Luidooo/luidlab/rack/desenhos/02-estrutura.tex

% ============================================================
%  MR2020-02  Frame assembly
%  A4 portrait, scale 1:5, first angle projection
% ============================================================
%  Included by mr2020.tex; does not compile on its own.

% ---------- scale and view origins (sheet coordinates, mm) ----------
\def\Esc{0.2}                  % 1:5
\def\FX{58}  \def\FY{162.2}    % front view, lower left corner
\def\LX{120} \def\LY{162.2}    % left side view
\def\TX{58}  \def\TY{66}       % top view

% rectangle in real coordinates inside a view: \ret[style]{ox}{oy}{x1}{y1}{x2}{y2}
\newcommand{\ret}[7][linhaA]{%
  \draw[#1] ({#2+(#4)*\Esc},{#3+(#5)*\Esc}) rectangle ({#2+(#6)*\Esc},{#3+(#7)*\Esc});}
% top view: front at the bottom (first angle), p measured from back to front
% L bracket seen square-on, right angle at (a,z), legs da and dz: \cant{ox}{oy}{a}{z}{da}{dz}
\newcommand{\cant}[6]{%
  \filldraw[linhaA, fill=cantoneira] ({#1+(#3)*\Esc},{#2+(#4)*\Esc}) -- ({#1+(#3+(#5))*\Esc},{#2+(#4)*\Esc})
    -- ({#1+(#3)*\Esc},{#2+(#4+(#6))*\Esc}) -- cycle;}
\newcommand{\retT}[4]{%
  \draw[linhaA] ({\TX+(#1)*\Esc},{\TY+(350-(#2))*\Esc}) rectangle ({\TX+(#3)*\Esc},{\TY+(350-(#4))*\Esc});}
% flat L bracket in the top view, right angle at (x,p), legs dx and dp: \cantT{x}{p}{dx}{dp}
\newcommand{\cantT}[4]{%
  \filldraw[linhaA, fill=cantoneira] ({\TX+(#1)*\Esc},{\TY+(350-(#2))*\Esc})
    -- ({\TX+(#1+(#3))*\Esc},{\TY+(350-(#2))*\Esc}) -- ({\TX+(#1)*\Esc},{\TY+(350-(#2+(#4)))*\Esc}) -- cycle;}

\begin{folha}

% ============================================================
%  FRONT VIEW
% ============================================================
% uprights cut to 579 (3.5..582.5), corner connectors adding 3.5 at the bottom and at the top
\ret{\FX}{\FY}{0}{3.5}{20}{582.5}
\ret{\FX}{\FY}{186}{3.5}{206}{582.5}
\ret{\FX}{\FY}{0}{0}{20}{3.5}
\ret{\FX}{\FY}{186}{0}{206}{3.5}
\ret{\FX}{\FY}{0}{582.5}{20}{586}
\ret{\FX}{\FY}{186}{582.5}{206}{586}
% front width rails, top and bottom
\ret{\FX}{\FY}{20}{566}{186}{586}
\ret{\FX}{\FY}{20}{0}{186}{20}
% back plane L brackets, seen through the frame; the front plane ones at the vertices fall on the same outline
\foreach \x/\d in {20/\CantL,186/-\CantL}{
  \cant{\FX}{\FY}{\x}{566}{\d}{-\CantL}
  \cant{\FX}{\FY}{\x}{20}{\d}{\CantL}}
% axis of symmetry
\draw[linhaG] ({\FX+103*\Esc},{\FY-2}) -- ({\FX+103*\Esc},{\FY+586*\Esc+2});

% dimensions
\cotaHor{\FX+10*\Esc}{\FX+196*\Esc}{156.5}{\FY}{\FY}{186}
\cotaHor{\FX}{\FX+206*\Esc}{151}{\FY}{\FY}{206}
\cotaVer{\FY}{\FY+586*\Esc}{46}{\FX}{\FX}{586}

% detail A callout at the top left vertex
\draw[linhaB] ({\FX+2},{\FY+586*\Esc-1}) circle (4.5mm);
\node[font=\fontsize{3mm}{3.4mm}\selectfont\bfseries] at ({\FX+8},{\FY+586*\Esc+3.6}) {A};

\balao{1}{104.5}{266}{\FX+196*\Esc}{230}
\balao{2}{70}{262}{70}{\FY+576*\Esc}

\node[txtvista] at ({\FX+103*\Esc},144.5) {FRONT VIEW};

% ============================================================
%  LEFT SIDE VIEW (first angle: right of the front view, front on the right)
% ============================================================
\ret{\LX}{\LY}{0}{3.5}{20}{582.5}
\ret{\LX}{\LY}{330}{3.5}{350}{582.5}
\ret{\LX}{\LY}{0}{0}{20}{3.5}
\ret{\LX}{\LY}{330}{0}{350}{3.5}
\ret{\LX}{\LY}{0}{582.5}{20}{586}
\ret{\LX}{\LY}{330}{582.5}{350}{586}
\ret{\LX}{\LY}{20}{566}{330}{586}
\ret{\LX}{\LY}{20}{0}{330}{20}
% side L brackets at the four vertices
\cant{\LX}{\LY}{20}{566}{\CantL}{-\CantL}
\cant{\LX}{\LY}{20}{20}{\CantL}{\CantL}
\cant{\LX}{\LY}{330}{566}{-\CantL}{-\CantL}
\cant{\LX}{\LY}{330}{20}{-\CantL}{\CantL}

% dimensions
\cotaHor{\LX}{\LX+350*\Esc}{156.5}{\LY}{\LY}{350}

\node[txtrot] at ({\LX+340*\Esc},282.6) {FRONT};
\balao{5}{108}{236}{\LX+25*\Esc}{\LY+560*\Esc}
\balao{3}{155}{230}{155}{\LY+574*\Esc}

\node[txtvista] at ({\LX+175*\Esc},144.5) {LEFT SIDE VIEW};

% ============================================================
%  TOP VIEW (first angle: below the front view, front at the bottom)
% ============================================================
\retT{0}{0}{20}{20}     \retT{186}{0}{206}{20}
\retT{0}{330}{20}{350}  \retT{186}{330}{206}{350}
\retT{20}{0}{186}{20}   \retT{20}{330}{186}{350}
\retT{0}{20}{20}{330}   \retT{186}{20}{206}{330}
% flat L brackets of the top frame (the base ones lie under them)
\cantT{20}{20}{\CantL}{\CantL}     \cantT{186}{20}{-\CantL}{\CantL}
\cantT{20}{330}{\CantL}{-\CantL}   \cantT{186}{330}{-\CantL}{-\CantL}
\draw[linhaG] ({\TX+103*\Esc},{\TY-1.5}) -- ({\TX+103*\Esc},{\TY+70+2});
\draw[linhaG] ({\TX-2},{\TY+35}) -- ({\TX+206*\Esc+2},{\TY+35});

\cotaVer{\TY}{\TY+350*\Esc}{106}{\TX+206*\Esc}{\TX+206*\Esc}{350}

\node[txtrot] at ({\TX+103*\Esc},62.3) {FRONT};
\node[txtvista] at ({\TX+103*\Esc},57) {TOP VIEW};

% ============================================================
%  DETAIL A, scale 2:1: top vertex with the corner connector
% ============================================================
% mapping: X = 132 + 2x ;  Y = 96 + 2(z - 566)
\draw[linhaA] (132,90) -- (132,129);          % outer face of the upright
\draw[linhaA] (172,90) -- (172,136);          % inner face / rail abutment
\draw[linhaA] (132,129) rectangle (172,136);  % connector over the upright end
\draw[linhaA] (172,136) -- (196,136);         % width rail, top face
\draw[linhaA] (172,96) -- (196,96);           % width rail, bottom face
\quebraH{132}{172}{90}
\quebraV{196}{96}{136}
\cotaVer{129}{136}{126.5}{132}{132}{3.5}
\balao{4}{188}{142}{160}{133}

\node[txtvista] at (164,84.5) {DETAIL A  (2:1)};
\node[txtnota] at (164,80.9) {3.5 mm connector at each upright end, bottom mirrored};

% ============================================================
%  ITEM LIST
% ============================================================
\begin{scope}[shift={(110,47)}]
  \draw[line width=0.35mm] (0,0) rectangle (88,32.4);
  \draw[linhaA] (0,28.8) -- (88,28.8);
  \foreach \y in {3.6,7.2,...,25.2}{\draw[linhaB] (0,\y) -- (88,\y);}
  \foreach \x in {10,55,65}{\draw[linhaB] (\x,0) -- (\x,32.4);}
  \def\cab{\fontsize{1.9mm}{2.2mm}\selectfont\bfseries}
  \def\cel{\fontsize{2.2mm}{2.6mm}\selectfont}
  \node[font=\cab] at (5,30.6) {ITEM};
  \node[font=\cab, anchor=west] at (11.2,30.6) {DESCRIPTION};
  \node[font=\cab] at (60,30.6) {QTY};
  \node[font=\cab, anchor=west] at (66.2,30.6) {NOTE};
  \def\lin#1#2#3#4#5{%
    \node[font=\cel] at (5,#1) {#2};
    \node[font=\cel, anchor=west] at (11.2,#1) {#3};
    \node[font=\cel] at (60,#1) {#4};
    \node[font=\cel, anchor=west] at (66.2,#1) {#5};}
  \lin{27}{1}{Upright}{4}{cut 579}
  \lin{23.4}{2}{Width rail}{4}{cut 166}
  \lin{19.8}{3}{Depth rail}{4}{cut 310}
  \lin{16.2}{4}{3-way corner connector}{8}{4 in stock}
  \lin{12.6}{5}{L corner bracket, 2 holes}{24}{16 in stock}
  \lin{9}{6}{M5 hammer nut, 20 series}{48}{8 in stock}
  \lin{5.4}{7}{M5 × 8 button head hex screw}{48}{purchased}
  \lin{1.8}{8}{M4 × 3 headless hex screw}{64}{32 in stock}
\end{scope}

% ============================================================
%  NOTES
% ============================================================
\node[anchor=north west, txtnota, text width=31mm, align=left, inner sep=0pt] at (22,136) {%
  \hyphenpenalty=10000\exhyphenpenalty=10000
  {\fontsize{2.6mm}{3mm}\selectfont\bfseries NOTES}\\[1.4mm]
  1. All dimensions are in mm; keep in mind that 1U~=~1.75~in~=~44.45~mm.\\[1mm]
  2. Heights measured from the frame base, at the bottom face of the lower connectors.\\[1mm]
  3. Each corner connector adds 3.5~mm, at the top and at the bottom vertices: uprights are
     cut to 579 and the frame totals 586. See detail~A.\\[1mm]
  4. First angle projection. The front is on the right in the side view and at the bottom in
     the top view.\\[1mm]
  5. Rails only at the base and top frames: no intermediate rails.\\[1mm]
  6. Cut lengths on sheet~03.\\[1mm]
  7. L brackets (5), three at each vertex: side plane, front or back plane, and flat in the
     base or top frame. Each takes two hammer nuts (6) and two screws (7).};

\legenda{FRAME ASSEMBLY}{20 × 20 extrusion, 8 in. × 12U format}{MR2020-02}{1:5}{2}{5}

\end{folha}
