Luidooo/luidlab/rack/desenhos/04-vertices.tex

% ============================================================
%  MR2020-04  Corner details
%  A4 portrait, isometric drawings at 1:1
%  Top back right vertex: A from inside the frame, B from outside the frame
%  Included by mr2020.tex; does not compile on its own.
% ============================================================

% ---------- 2020 profile section, local coordinates centred on the profile ----------
\def\perfil{(-10,-10) -- (-3,-10) -- (-3,-8) -- (-5,-8) -- (-5,-5.5) -- (5,-5.5) -- (5,-8)
  -- (3,-8) -- (3,-10) -- (10,-10) -- (10,-3) -- (8,-3) -- (8,-5) -- (5.5,-5) -- (5.5,5)
  -- (8,5) -- (8,3) -- (10,3) -- (10,10) -- (3,10) -- (3,8) -- (5,8) -- (5,5.5) -- (-5,5.5)
  -- (-5,8) -- (-3,8) -- (-3,10) -- (-10,10) -- (-10,3) -- (-8,3) -- (-8,5) -- (-5.5,5)
  -- (-5.5,-5) -- (-8,-5) -- (-8,-3) -- (-10,-3) -- cycle}
% cut end: voids (slots, chambers, bore) in the slot colour, material white and hatched.
% The background is a polygon, not "rectangle": rectangle ignores the skewed plane.
\newcommand{\secao}{%
  \fill[canal] (-10,-10) -- (10,-10) -- (10,10) -- (-10,10) -- cycle;
  \fill[white, even odd rule] \perfil (0,0) circle (2.1);
  \path[pattern=north east lines, even odd rule] \perfil (0,0) circle (2.1);
  \draw[linhaA] \perfil;
  \draw[linhaA] (0,0) circle (2.1);}

\begin{folha}

\def\projecao{\node[anchor=base west, font=\fontsize{3mm}{3.4mm}\selectfont\bfseries] at (126.5,19.5) {ISOMETRIC};}

\node[txtvista, anchor=west] at (24,281) {CORNER DETAILS \quad TOP BACK RIGHT VERTEX \quad 1:1};
\node[font=\fontsize{2.6mm}{3mm}\selectfont\bfseries, anchor=west] at (24,272) {A \quad INSIDE THE FRAME};
\node[font=\fontsize{2.6mm}{3mm}\selectfont\bfseries, anchor=west] at (24,178) {B \quad OUTSIDE THE FRAME};

% ============================================================
%  A  INSIDE: viewer at -X, -Y, +Z
%  sheet point P = (234.7 + 0.866 (X - Y),  -592 + 0.5 (X + Y) + Z)
%  rail stubs 40 mm, upright stub 526..582.5
% ============================================================
\begin{scope}[shift={(234.7,-592)},
    x={(0.8660254mm,0.5mm)}, y={(-0.8660254mm,0.5mm)}, z={(0mm,1mm)}]

  % ---- upright stub, broken below (X 186..206, Y 330..350, Z 526..582.5) ----
  \fill[white] (186,330,526) -- (186,350,526) -- (186,350,582.5) -- (186,330,582.5) -- cycle;
  \fill[white] (186,330,526) -- (206,330,526) -- (206,330,582.5) -- (186,330,582.5) -- cycle;
  \fill[canal] (186,337,526) -- (186,343,526) -- (186,343,582.5) -- (186,337,582.5) -- cycle;
  \fill[canal] (193,330,526) -- (199,330,526) -- (199,330,582.5) -- (193,330,582.5) -- cycle;
  \foreach \o in {7,13}{
    \draw[linhaB] (186,{330+\o},526) -- (186,{330+\o},582.5);
    \draw[linhaB] ({186+\o},330,526) -- ({186+\o},330,582.5);}
  \draw[linhaA] (186,350,526) -- (186,350,582.5);
  \draw[linhaA] (186,330,526) -- (186,330,582.5);
  \draw[linhaA] (206,330,526) -- (206,330,582.5);
  \draw[linhaB] (186,350,526) -- (186,330,526) -- (206,330,526);   % break

  % ---- corner connector, schematic plate (Z 582.5..586): left, front and top faces ----
  \filldraw[linhaA, fill=conector] (186,330,582.5) -- (186,350,582.5) -- (186,350,586) -- (186,330,586) -- cycle;
  \filldraw[linhaA, fill=conector] (186,330,582.5) -- (206,330,582.5) -- (206,330,586) -- (186,330,586) -- cycle;
  \filldraw[linhaA, fill=conector] (186,330,586) -- (206,330,586) -- (206,350,586) -- (186,350,586) -- cycle;

  % ---- L brackets under the rails: side plane on the upright front face, back plane on its inner face ----
  \vista{-1}{-1}{1}
  \cantYZ{187}{205}{330}{566}{-\CantL}{-\CantL}
  \cantXZ{331}{349}{186}{566}{-\CantL}{-\CantL}

  % ---- width rail stub, cut at X = 146 (X 146..186, Y 330..350, Z 566..586) ----
  \filldraw[linhaA, fill=white] (146,330,566) -- (186,330,566) -- (186,330,586) -- (146,330,586) -- cycle;
  \filldraw[linhaA, fill=white] (146,330,586) -- (186,330,586) -- (186,350,586) -- (146,350,586) -- cycle;
  \fill[canal] (146,330,573) -- (186,330,573) -- (186,330,579) -- (146,330,579) -- cycle;
  \fill[canal] (146,337,586) -- (186,337,586) -- (186,343,586) -- (146,343,586) -- cycle;
  \foreach \o in {7,13}{
    \draw[linhaB] (146,330,{566+\o}) -- (186,330,{566+\o});
    \draw[linhaB] (146,{330+\o},586) -- (186,{330+\o},586);}
  \begin{scope}[shift={(146,340,576)}, x={(-0.8660254mm,0.5mm)}, y={(0mm,1mm)}]
    \secao
  \end{scope}

  % ---- depth rail stub, cut at Y = 290 (X 186..206, Y 290..330, Z 566..586) ----
  \filldraw[linhaA, fill=white] (186,290,566) -- (186,330,566) -- (186,330,586) -- (186,290,586) -- cycle;
  \filldraw[linhaA, fill=white] (186,290,586) -- (206,290,586) -- (206,330,586) -- (186,330,586) -- cycle;
  \fill[canal] (186,290,573) -- (186,330,573) -- (186,330,579) -- (186,290,579) -- cycle;
  \fill[canal] (193,290,586) -- (199,290,586) -- (199,330,586) -- (193,330,586) -- cycle;
  \foreach \o in {7,13}{
    \draw[linhaB] (186,290,{566+\o}) -- (186,330,{566+\o});
    \draw[linhaB] ({186+\o},290,586) -- ({186+\o},330,586);}
  \begin{scope}[shift={(196,290,576)}, x={(0.8660254mm,0.5mm)}, y={(0mm,1mm)}]
    \secao
  \end{scope}

  % ---- flat L bracket in the top frame, inner corner between the two rails (Z 567..585) ----
  \cantXY{567}{585}{186}{330}{-\CantL}{-\CantL}
\end{scope}

\chamada{110}{262}{140}{276}{south west}{CORNER CONNECTOR (4)}
\chamada{110}{232}{165}{252}{west}{FLAT L BRACKET (5)}
\chamada{84}{247}{45}{262}{south west}{SLOT, 6 mm OPENING}
\chamada{66.7}{222}{40}{200}{north west}{WIDTH RAIL (2), CUT END}
\chamada{153.3}{222}{180}{200}{north east}{DEPTH RAIL (3), CUT END}
\chamada{118.7}{197}{118.7}{190}{north}{UPRIGHT (1), BROKEN BELOW}
\chamada{103.3}{222}{85}{196}{north east}{L BRACKET (5)}
\fill (116.7,222.5) circle (0.35mm);
\draw[linhaB] (116.7,222.5) -- (85,196);

% ============================================================
%  B  OUTSIDE: viewer at +X, +Y, +Z
%  sheet point P = (-14.7 + 0.866 (Y - X),  -183 + Z - 0.5 (X + Y))
% ============================================================
\begin{scope}[shift={(-14.7,-183)},
    x={(-0.8660254mm,-0.5mm)}, y={(0.8660254mm,-0.5mm)}, z={(0mm,1mm)}]

  % ---- L brackets under the rails, outer faces seen below the rail stubs ----
  \vista{1}{1}{1}
  \cantYZ{187}{205}{330}{566}{-\CantL}{-\CantL}
  \cantXZ{331}{349}{186}{566}{-\CantL}{-\CantL}

  % ---- width rail stub (X 146..186, Y 330..350, Z 566..586): back and top faces ----
  \filldraw[linhaA, fill=white] (146,350,566) -- (186,350,566) -- (186,350,586) -- (146,350,586) -- cycle;
  \filldraw[linhaA, fill=white] (146,330,586) -- (186,330,586) -- (186,350,586) -- (146,350,586) -- cycle;
  \fill[canal] (146,350,573) -- (186,350,573) -- (186,350,579) -- (146,350,579) -- cycle;
  \fill[canal] (146,337,586) -- (186,337,586) -- (186,343,586) -- (146,343,586) -- cycle;
  \foreach \o in {7,13}{
    \draw[linhaB] (146,350,{566+\o}) -- (186,350,{566+\o});
    \draw[linhaB] (146,{330+\o},586) -- (186,{330+\o},586);}

  % ---- depth rail stub (X 186..206, Y 290..330, Z 566..586): right and top faces ----
  \filldraw[linhaA, fill=white] (206,290,566) -- (206,330,566) -- (206,330,586) -- (206,290,586) -- cycle;
  \filldraw[linhaA, fill=white] (186,290,586) -- (206,290,586) -- (206,330,586) -- (186,330,586) -- cycle;
  \fill[canal] (206,290,573) -- (206,330,573) -- (206,330,579) -- (206,290,579) -- cycle;
  \fill[canal] (193,290,586) -- (199,290,586) -- (199,330,586) -- (193,330,586) -- cycle;
  \foreach \o in {7,13}{
    \draw[linhaB] (206,290,{566+\o}) -- (206,330,{566+\o});
    \draw[linhaB] ({186+\o},290,586) -- ({186+\o},330,586);}

  % ---- upright stub, broken below (X 186..206, Y 330..350, Z 526..582.5): right and back faces ----
  \fill[white] (206,330,526) -- (206,350,526) -- (206,350,582.5) -- (206,330,582.5) -- cycle;
  \fill[white] (186,350,526) -- (206,350,526) -- (206,350,582.5) -- (186,350,582.5) -- cycle;
  \fill[canal] (206,337,526) -- (206,343,526) -- (206,343,582.5) -- (206,337,582.5) -- cycle;
  \fill[canal] (193,350,526) -- (199,350,526) -- (199,350,582.5) -- (193,350,582.5) -- cycle;
  \foreach \o in {7,13}{
    \draw[linhaB] (206,{330+\o},526) -- (206,{330+\o},582.5);
    \draw[linhaB] ({186+\o},350,526) -- ({186+\o},350,582.5);}
  \draw[linhaA] (206,330,526) -- (206,330,582.5);
  \draw[linhaA] (206,350,526) -- (206,350,582.5);
  \draw[linhaA] (186,350,526) -- (186,350,582.5);
  \draw[linhaB] (206,330,526) -- (206,350,526) -- (186,350,526);   % break

  % ---- corner connector: outer side strips and top plate ----
  \filldraw[linhaA, fill=conector] (206,330,582.5) -- (206,350,582.5) -- (206,350,586) -- (206,330,586) -- cycle;
  \filldraw[linhaA, fill=conector] (186,350,582.5) -- (206,350,582.5) -- (206,350,586) -- (186,350,586) -- cycle;
  \filldraw[linhaA, fill=conector] (186,330,586) -- (206,330,586) -- (206,350,586) -- (186,350,586) -- cycle;
\end{scope}

\chamada{110}{135}{110}{168}{south}{CORNER CONNECTOR (4)}
\chamada{144.6}{135}{180}{150}{south}{SLOT, 6 mm OPENING}
\chamada{127.3}{122}{170}{95}{north west}{OUTER FACES FLUSH}
\chamada{118.7}{70}{150}{62}{west}{UPRIGHT (1), BROKEN BELOW}
\chamada{87.7}{112}{60}{95}{north east}{L BRACKET (5)}
\chamada{132.3}{112}{150}{80}{north west}{L BRACKET (5)}

% ============================================================
%  NOTES
% ============================================================
\node[anchor=north west, txtnota, text width=120mm, align=left, inner sep=0pt] at (24,63) {%
  \hyphenpenalty=10000\exhyphenpenalty=10000
  {\fontsize{2.6mm}{3mm}\selectfont\bfseries NOTES}\\[1mm]
  1. A: seen from inside the frame; the cut ends of the rails show the 2020 profile section.\\[0.6mm]
  2. B: seen from outside the frame; the outer faces of the upright and rails are flush.\\[0.6mm]
  3. Corner connector and L brackets drawn schematically. Item numbers as on sheets 01 to 03.\\[0.6mm]
  4. Each vertex takes three L brackets: side plane, front or back plane, and flat between the rails (hidden in B).};

\legenda{CORNER DETAILS}{Top back right vertex, inside and outside views}{MR2020-04}{1:1}{4}{5}

\end{folha}
