Luidooo/luidlab/rack/desenhos/05-unidades.tex

% ============================================================
%  MR2020-05  Rack unit layout
%  A4 portrait, front view, scale 1:2.5, first angle projection
%  Included by mr2020.tex; does not compile on its own.
% ============================================================
% Real coordinates inside the drawing scope: x across the frame (0..206), z from the frame base (0..586).
% Sheet point = (44 + 0.4 x, 47.5 + 0.4 z).  U zone: z 26.3 .. 559.7, 1U = 44.45.

% bay (tray) for a group of U:  \baia{first U}{number of U}
% draws the two mounting ears with 3 holes per U and the shelf plate,
% and leaves \zt / \zb (top and bottom of the bay) for the equipment drawn next
\newcommand{\baia}[2]{%
  \pgfmathsetmacro{\zt}{559.7-(#1-1)*44.45}%
  \pgfmathsetmacro{\zb}{\zt-#2*44.45}%
  \filldraw[linhaA, fill=white] (1.4,{\zb+0.5}) rectangle (20,{\zt-0.5});
  \filldraw[linhaA, fill=white] (186,{\zb+0.5}) rectangle (204.6,{\zt-0.5});
  \filldraw[linhaA, fill=white] (20,{\zb+0.5}) rectangle (186,{\zb+3.5});
  \foreach \k in {1,...,#2}{
    \foreach \f in {6.35,22.225,38.1}{
      \draw[linhaB] (10,{\zt-(\k-1)*44.45-\f}) circle (2.75);
      \draw[linhaB] (196,{\zt-(\k-1)*44.45-\f}) circle (2.75);}}}

% label for the last bay, leader from a point on the equipment:  \rotulo{x}{z}{title}{specs}
\newcommand{\rotulo}[4]{%
  \fill ({#1},{#2}) circle (0.9);
  \draw[linhaB] ({#1},{#2}) -- (230,{(\zt+\zb)/2});
  \node[anchor=west, align=left, inner sep=0pt, font=\fontsize{2.1mm}{2.9mm}\selectfont]
    at (235,{(\zt+\zb)/2}) {{\fontsize{2.5mm}{3mm}\selectfont\bfseries #3}\\#4};}

\begin{folha}

\begin{scope}[shift={(44,47.5)}, scale=0.4]

  % ---------- frame: uprights with front slot, connectors, front width rails ----------
  \foreach \x in {0,186}{
    \filldraw[linhaA, fill=white] (\x,3.5) rectangle ({\x+20},582.5);
    \fill[canal] ({\x+7},3.5) rectangle ({\x+13},582.5);
    \draw[linhaB] ({\x+7},3.5) -- ({\x+7},582.5);
    \draw[linhaB] ({\x+13},3.5) -- ({\x+13},582.5);
    \filldraw[linhaA, fill=conector] (\x,0) rectangle ({\x+20},3.5);
    \filldraw[linhaA, fill=conector] (\x,582.5) rectangle ({\x+20},586);}
  \foreach \z in {0,566}{
    \filldraw[linhaA, fill=white] (20,\z) rectangle (186,{\z+20});
    \fill[canal] (20,{\z+7}) rectangle (186,{\z+13});
    \draw[linhaB] (20,{\z+7}) -- (186,{\z+7});
    \draw[linhaB] (20,{\z+13}) -- (186,{\z+13});}

  % ---------- U ruler ----------
  \draw[linhaB] (-10,26.3) -- (-10,559.7);
  \foreach \n in {0,...,12}{\draw[linhaB] (-10,{26.3+\n*44.45}) -- (-14,{26.3+\n*44.45});}
  \foreach \n in {1,...,12}{
    \node[anchor=east, font=\fontsize{2.3mm}{2.6mm}\selectfont] at (-16,{559.7-(\n-0.5)*44.45}) {U\n};}

  % ---------- title ----------
  \node[anchor=west, font=\fontsize{3.2mm}{3.8mm}\selectfont\bfseries] at (235,583.75) {RACK UNIT LAYOUT};
  \node[anchor=west, font=\fontsize{2.5mm}{3mm}\selectfont] at (235,573.75) {FRONT VIEW \quad 1:2.5};

  % ---------- U1  exhaust fans, lying flat ----------
  \baia{1}{1}
  \filldraw[linhaA, fill=white] (33,{\zb+3.5}) rectangle (173,{\zb+28.5});
  \rotulo{173}{\zb+16}{U1 \quad EXHAUST}{2× fan, 140 × 140 × 25}

  % ---------- U2  switch ----------
  \baia{2}{1}
  \filldraw[linhaA, fill=white] (24,{\zb+3.5}) rectangle (182,{\zb+28.5});
  \rotulo{182}{\zb+16}{U2 \quad SWITCH}{TP-Link TL-SG108, 158 × 101 × 25}

  % ---------- U3  two SBCs ----------
  \baia{3}{1}
  \filldraw[linhaA, fill=white] (43,{\zb+3.5}) rectangle (93,{\zb+19.5});
  \filldraw[linhaA, fill=white] (113,{\zb+3.5}) rectangle (163,{\zb+19.5});
  \rotulo{163}{\zb+11.5}{U3 \quad SBC PAIR}{2× Orange Pi Zero 3, 50 × 55 × 16}

  % ---------- U4-5  NAS ----------
  \baia{4}{2}
  \filldraw[linhaA, fill=white] (56,{\zb+3.5}) rectangle (150,{\zb+73.5});
  \rotulo{150}{\zb+38.5}{U4-5 \quad NAS}{SBC + Penta SATA HAT + 4× SSD, 94 × 175 × 70}

  % ---------- U6-7  mini PC ----------
  \baia{6}{2}
  \filldraw[linhaA, fill=white] (38,{\zb+3.5}) rectangle (168,{\zb+63.5});
  \rotulo{168}{\zb+33.5}{U6-7 \quad MINI PC}{AOOSTAR GEM12, 130 × 130 × 60}

  % ---------- U8-9  GPU, lying ----------
  \baia{8}{2}
  \filldraw[linhaA, fill=white] (36,{\zb+3.5}) rectangle (170,{\zb+54.5});
  \rotulo{170}{\zb+29}{U8-9 \quad GPU}{Lying card via OCuLink, $\leq$250 × 134 × 51}

  % ---------- U10-11  power: ATX at the rear (hidden), bricks in front ----------
  \baia{10}{2}
  \draw[linhaF] (28,{\zb+1.5}) rectangle (178,{\zb+87.5});
  \foreach \bx in {39,107}{
    \foreach \bz in {3.5,33.5}{
      \filldraw[linhaA, fill=white] (\bx,{\zb+\bz}) rectangle ({\bx+60},{\zb+\bz+30});}}
  \rotulo{167}{\zb+33.5}{U10-11 \quad POWER}{ATX PS/2 at the rear (dashed) + 4 bricks, est.}

  % ---------- U12  intake fans, lying flat ----------
  \baia{12}{1}
  \filldraw[linhaA, fill=white] (33,{\zb+3.5}) rectangle (173,{\zb+28.5});
  \rotulo{173}{\zb+16}{U12 \quad INTAKE}{2× fan, 140 × 140 × 25}

\end{scope}

\legenda{RACK UNIT LAYOUT}{Front view, tray and equipment allocation per U}{MR2020-05}{1:2.5}{5}{5}

\end{folha}
