Luidooo/luidlab/rack/desenhos/bloco-1u.pdf

## 1U NUT BLOCK PROPOSAL FOR APPROVAL

6.35

22.225

38.1

44.45 (1U)

3.9

2.6

1.3

## FRONT VIEW 2:1

A B

3.15 | 6.4 | 9.475

10.4
8.4

## TOP VIEW 2:1

10.4

7.4

3.9

1.4

## SECTION A-A 4:1

between two nuts

### 10.5 nut

8.4

1.3

0.5

## SECTION B-B 4:1

through a nut

20

22.8

29.15

44.45

CONNECTOR ARM

M5 DROP-IN NUT

BLOCK U1 | BLOCK U2
STACK IN THE FRONT SLOT | 1.5:1

## NOTES

1. All dimensions in mm. Proposal for approval: not modeled yet.
2. 12 identical blocks per front upright, 24 in all, slid in from the upright end before the corner connector goes on. Print floor down, pockets up, no supports.
3. Holds the M5 drop-in nut 10.5 × 6 × 3.3 (neck 6 × 6 × 1), turned across the slot: its 6 mm side runs along the slot, in a 6.4 pocket.
4. Profile cavity assumed 11 wide under the 1.2 lips and 5.5 deep from the face to the core, 0.2 to 0.3 clear on every side: to be confirmed with a test print.
5. The connector arm takes the first 20 mm of the slot. The stack rests on the lower arm, so the U grid sits 2.8 lower than on sheet 02; the pitch is unchanged.

OWNER

## LUIDLAB · MINIRACK PROJECT · 8 U. · 20 × 20 ALUMINUM EXTRUSION

TITLE

# 1U NUT BLOCK

Printed spacer for the M5 drop-in nuts in the front slot, proposal

PROJECTION | UNIT
mm

MATERIAL

### PETG, 3D printed, 100 % infill

STANDARDS

ISO 5457 · 7200 · 128 · 129-1

DRAWING NO.
MR2020-06

SCALE
2:1, 4:1

SHEET
1 / 1

DATE
2026-10-29

REV.
A
