Luidooo/luidlab/rack/desenhos/params.tex

% ============================================================
%  MINI RACK 2020, cotas mestras (mm)
%  Fonte única de verdade. Alterar aqui recompila tudo.
% ============================================================

% ---------- estrutura ----------
\def\Perfil{20}            % extrusão 2020
\def\RackL{206}            % largura externa
\def\RackP{350}            % profundidade externa
\def\RackA{586}            % altura total da estrutura, conectores incluídos
\def\Conector{3.5}          % acréscimo de cada conector de canto: vale no topo E na base
\def\Coluna{579}           % corte do upright = RackA - 2 x Conector

\def\CantL{20}            % perna da cantoneira L (catálogo), largura 18 sobre a face de 20

% ---------- cortes ----------
\def\TravL{166}            % width rail, 4 peças (base e topo)
\def\TravP{310}            % depth rail, 4 peças (base e topo)

% ---------- rack 8" custom ----------
\def\Furos{186}            % eixo a eixo dos furos
\def\Painel{203.2}         % largura do painel (8 polegadas)
\def\Vao{166}              % vão livre entre colunas

% ---------- unidades ----------
\def\Uu{44.45}             % 1U
\def\NU{12}                % número de unidades
\def\ZonaU{533.4}          % 12U

% Referências verticais
\def\UTopoEstr{26.3}       % topo do U1, a partir do topo da estrutura
\def\UTopoCol{22.8}        % topo do U1, a partir da ponta superior do upright

% furação EIA-310 dentro de 1U (a partir do topo do U)
\def\FuroA{6.35}
\def\FuroB{22.225}
\def\FuroC{38.1}
