Luidooo/luidlab/rack/modelos3d/teste-bloco-1u.stl

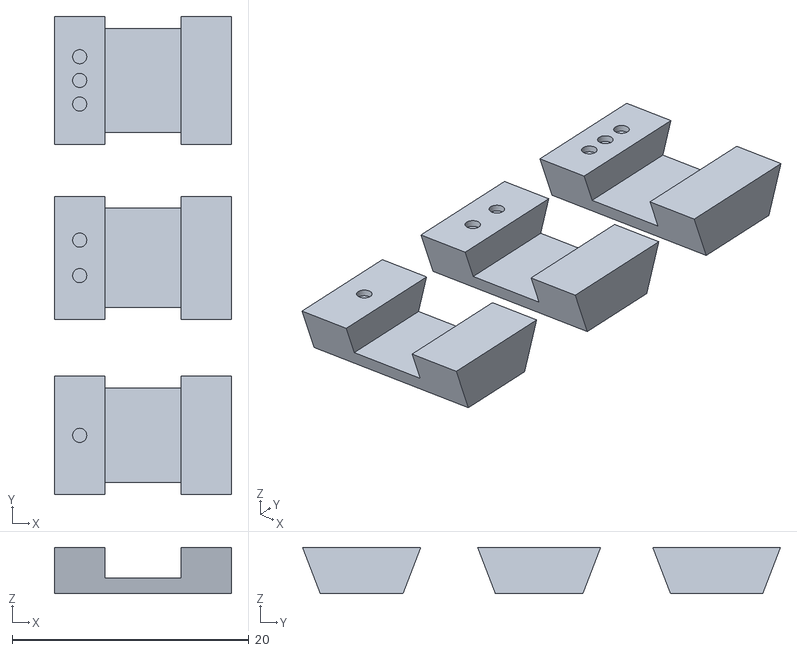
[picture p3: CAD file, 2026-10-29]
rack/modelos3d/teste-bloco-1u.stl
15.0 x 40.4 x 3.90
