Luidooo/luidlab/rack/desenhos/mr2020.pdf

## ISOMETRIC VIEW 1:5

1

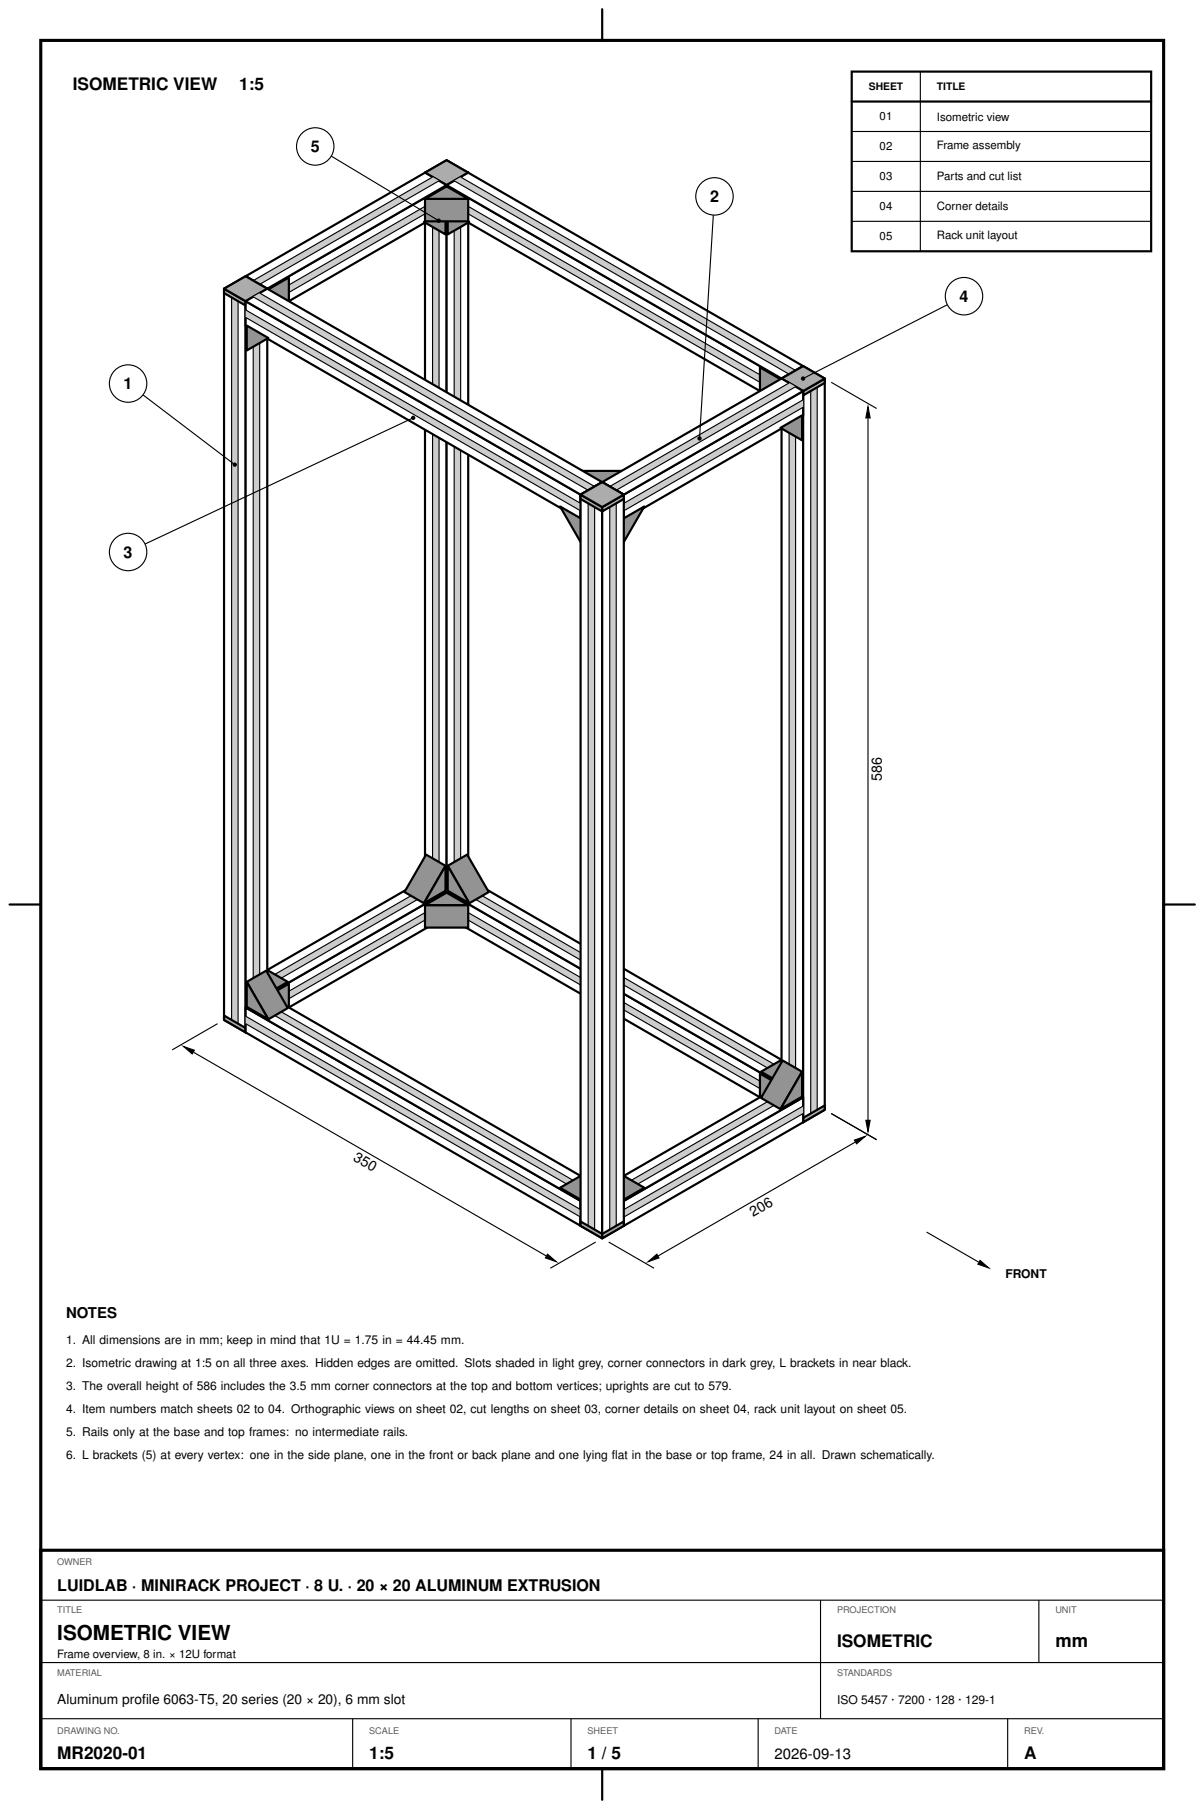
[picture p4: page 1]
FRONT; SHEET; TITLE; Isometric view; Frame assembly; Parts and cut list; Corner details; Rack unit layout; NOTES; TITLE ISOMETRIC VIEW; PROJECTION; ISOMETRIC; UNIT; STANDARDS; ISO 5457 · 7200 · 128 · 129-1; DRAWING NO. MR2020-01; SCALE 1:5; SHEET 1 / 5; DATE; REV. A

1. All dimensions are in mm; keep in mind that 1U = 1.75 in = 44.45 mm.

2. Isometric drawing at 1:5 on all three axes. Hidden edges are omitted. Slots shaded in light grey, corner connectors in dark grey, L brackets in near black.

3. The overall height of 586 includes the 3.5 mm corner connectors at the top and bottom vertices; uprights are cut to 579.

4. Item numbers match sheets 02 to 04. Orthographic views on sheet 02, cut lengths on sheet 03, corner details on sheet 04, rack unit layout on sheet 05.

5. Rails only at the base and top frames: no intermediate rails.

6. L brackets (5) at every vertex: one in the side plane, one in the front or back plane and one lying flat in the base or top frame, 24 in all. Drawn schematically.

OWNER
LUIDLAB · MINIRACK PROJECT · 8 U. · 20 × 20 ALUMINUM EXTRUSION

Frame overview, 8 in. × 12U format

MATERIAL
Aluminum profile 6063-T5, 20 series (20 × 20), 6 mm slot

1
2

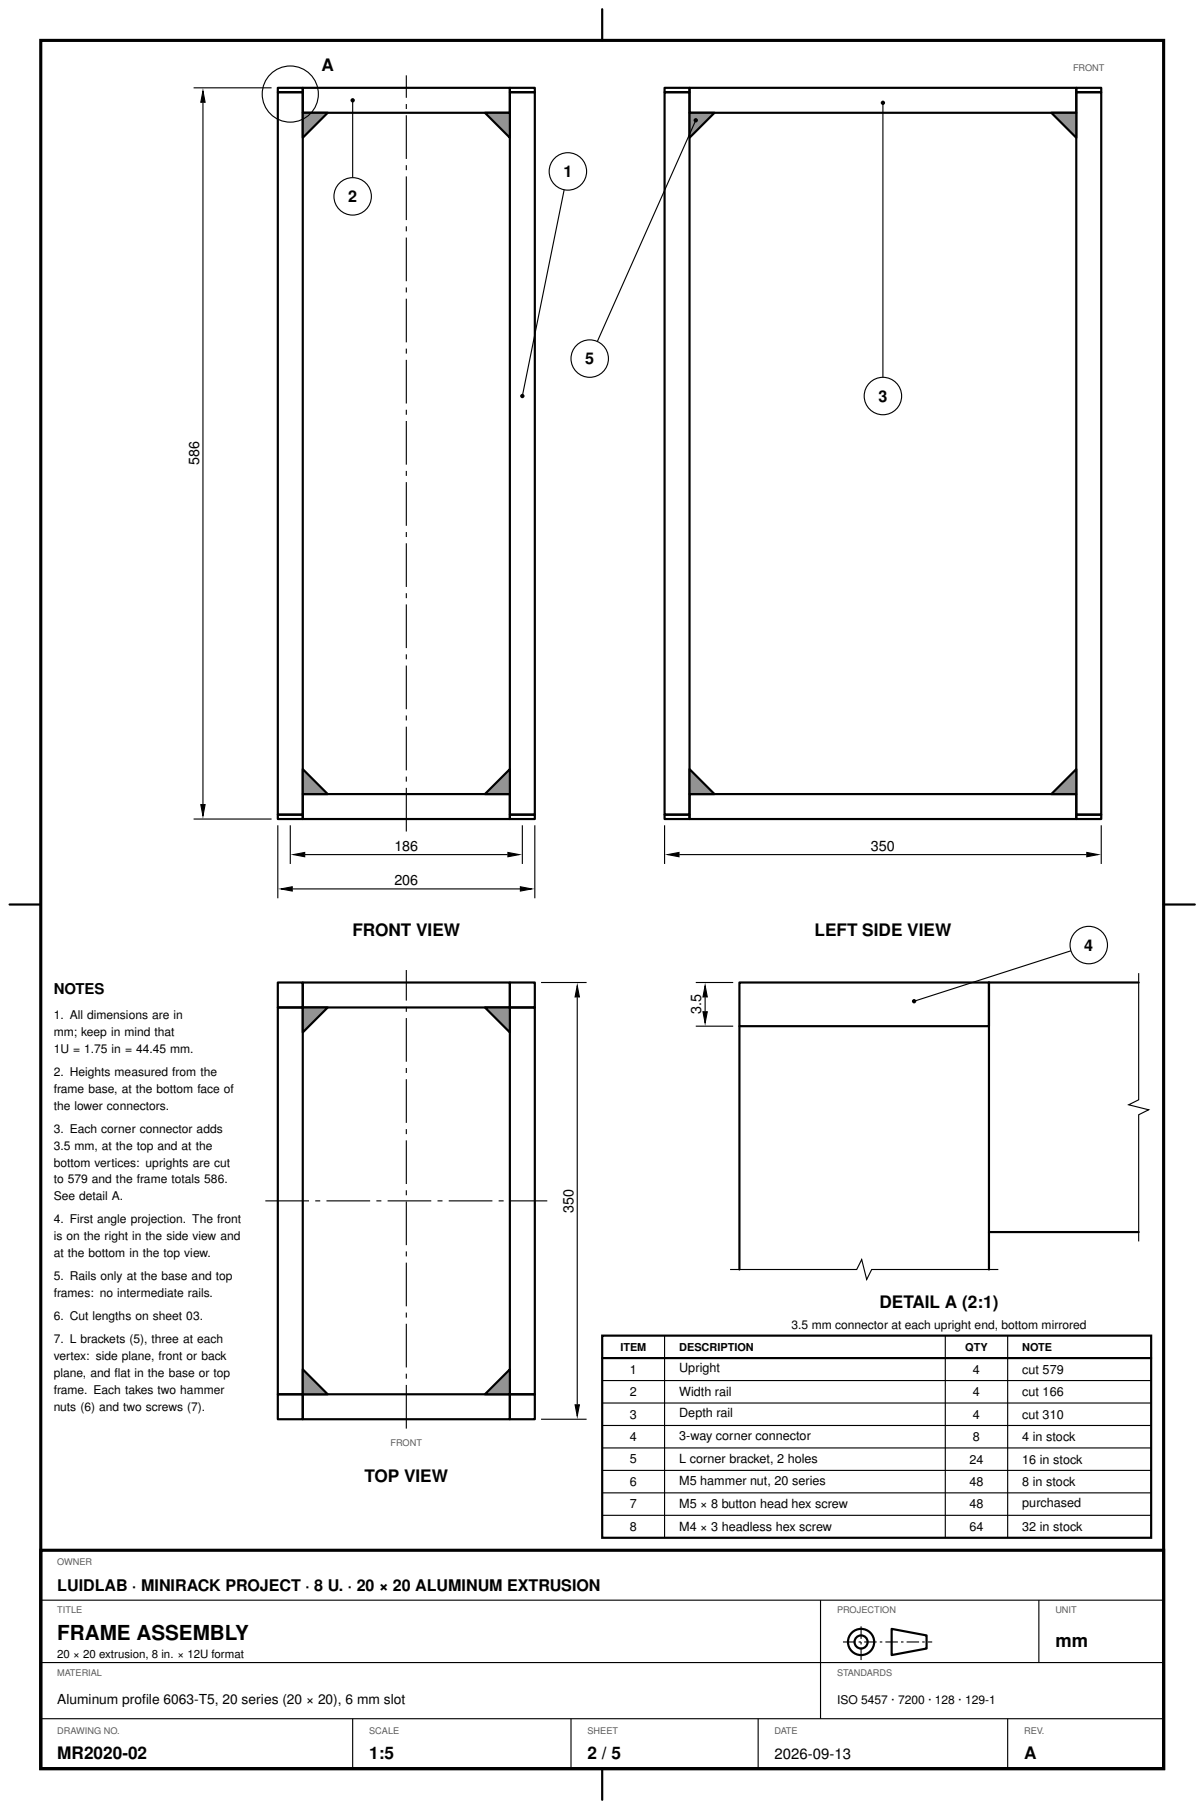
[picture p5: page 2]
FRONT VIEW; FRONT; TOP VIEW; DETAIL A (2:1); ITEM; DESCRIPTION; QTY; NOTE; Upright; cut 579; Width rail; cut 166; Depth rail; cut 310; 3-way corner connector; 4 in stock; L corner bracket, 2 holes; 16 in stock; M5 hammer nut, 20 series; 8 in stock; M5 × 8 button head hex screw; purchased; M4 × 3 headless hex screw; 32 in stock; NOTES; TITLE FRAME ASSEMBLY; PROJECTION; UNIT

LEFT SIDE VIEW

1. All dimensions are in
mm; keep in mind that

2. Heights measured from the
frame base, at the bottom face of
the lower connectors.

3. Each corner connector adds
3.5 mm, at the top and at the
bottom vertices: uprights are cut
to 579 and the frame totals 586.
See detail A.

4. First angle projection. The front
is on the right in the side view and
at the bottom in the top view.

5. Rails only at the base and top
frames: no intermediate rails.

6. Cut lengths on sheet 03.

3.5 mm connector at each upright end, bottom mirrored

7. L brackets (5), three at each
vertex: side plane, front or back
plane, and flat in the base or top
frame. Each takes two hammer
nuts (6) and two screws (7).

OWNER
LUIDLAB · MINIRACK PROJECT · 8 U. · 20 × 20 ALUMINUM EXTRUSION

20 × 20 extrusion, 8 in. × 12U format

ITEM 1 | UPRIGHT | QTY 4 | 1:2
ITEM 3 | DEPTH RAIL | QTY 4 | 1:2

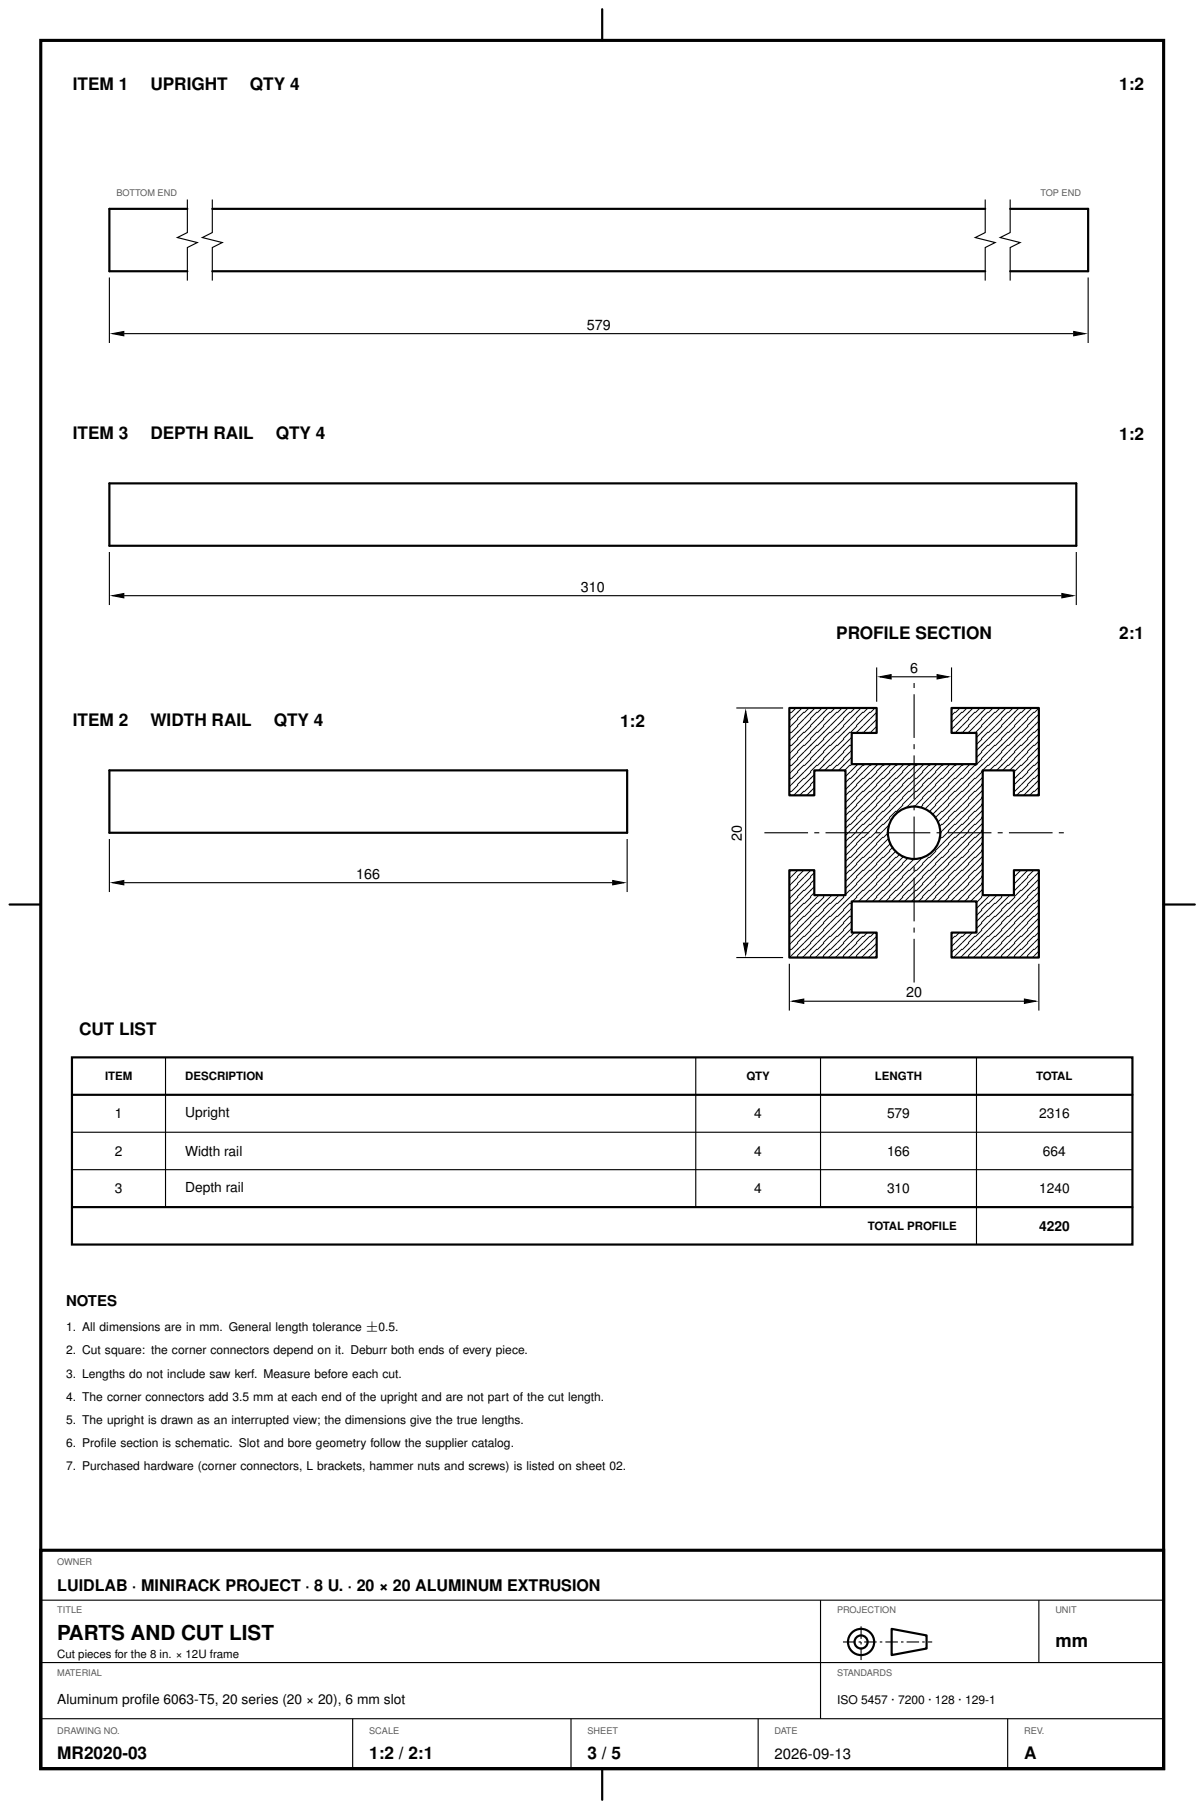
[picture p6: page 3]
BOTTOM END; TOP END; ITEM 2; WIDTH RAIL; QTY 4; PROFILE SECTION; CUT LIST; ITEM; DESCRIPTION; QTY; LENGTH; TOTAL; Upright; Width rail; Depth rail; TOTAL PROFILE; NOTES; PROJECTION; UNIT

1. All dimensions are in mm. General length tolerance ±0.5.

2. Cut square: the corner connectors depend on it. Deburr both ends of every piece.

3. Lengths do not include saw kerf. Measure before each cut.

4. The corner connectors add 3.5 mm at each end of the upright and are not part of the cut length.

5. The upright is drawn as an interrupted view; the dimensions give the true lengths.

6. Profile section is schematic. Slot and bore geometry follow the supplier catalog.

7. Purchased hardware (corner connectors, L brackets, hammer nuts and screws) is listed on sheet 02.

OWNER
LUIDLAB · MINIRACK PROJECT · 8 U. · 20 × 20 ALUMINUM EXTRUSION

TITLE
PARTS AND CUT LIST

Cut pieces for the 8 in. × 12U frame

CORNER DETAILS | TOP BACK RIGHT VERTEX | 1:1

## A INSIDE THE FRAME

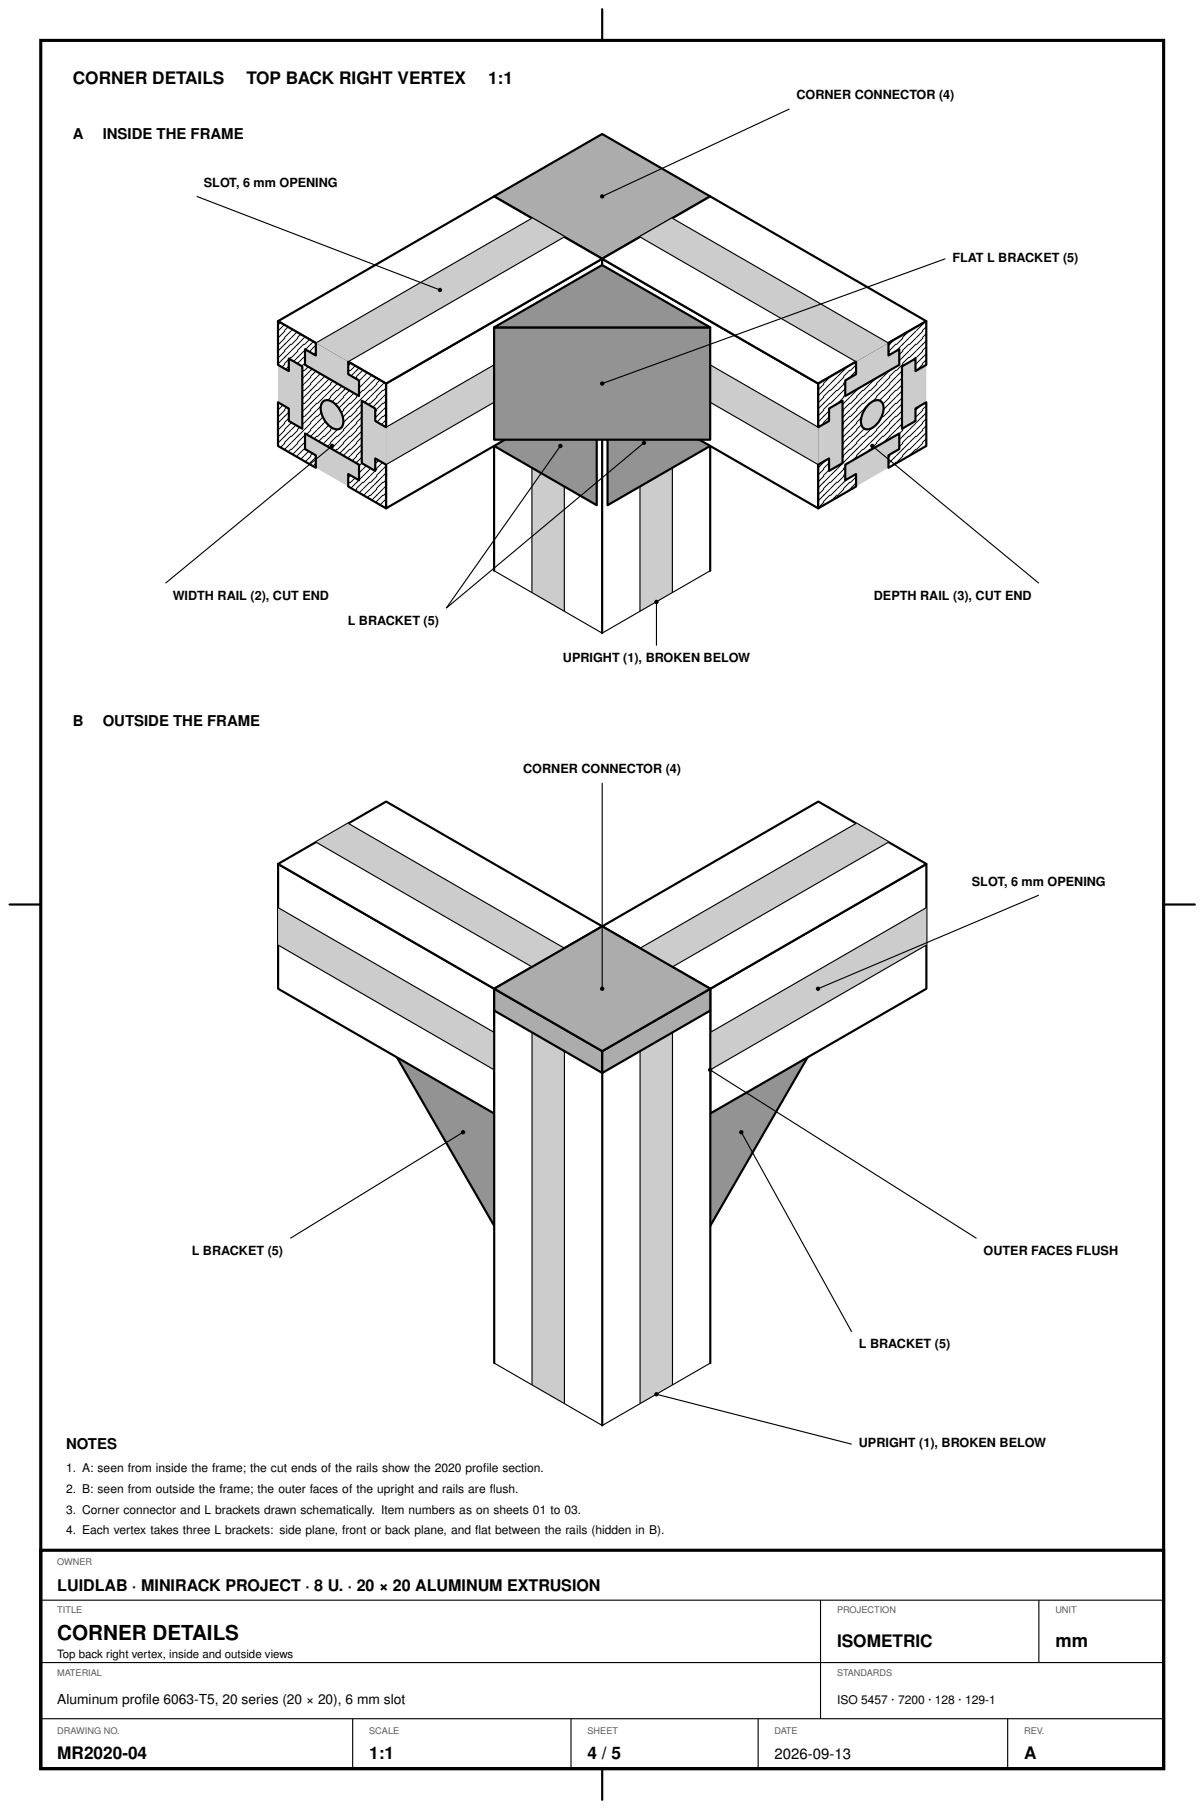
[picture p7: page 4]
CORNER CONNECTOR (4); FLAT L BRACKET (5); WIDTH RAIL (2), CUT END; DEPTH RAIL (3), CUT END; L BRACKET (5); NOTES; TITLE CORNER DETAILS; PROJECTION; ISOMETRIC; UNIT

SLOT, 6 mm OPENING

UPRIGHT (1), BROKEN BELOW

B OUTSIDE THE FRAME

OUTER FACES FLUSH

1. A: seen from inside the frame; the cut ends of the rails show the 2020 profile section.
2. B: seen from outside the frame; the outer faces of the upright and rails are flush.
3. Corner connector and L brackets drawn schematically. Item numbers as on sheets 01 to 03.
4. Each vertex takes three L brackets: side plane, front or back plane, and flat between the rails (hidden in B).

OWNER
LUIDLAB · MINIRACK PROJECT · 8 U. · 20 × 20 ALUMINUM EXTRUSION

Top back right vertex, inside and outside views

## RACK UNIT LAYOUT

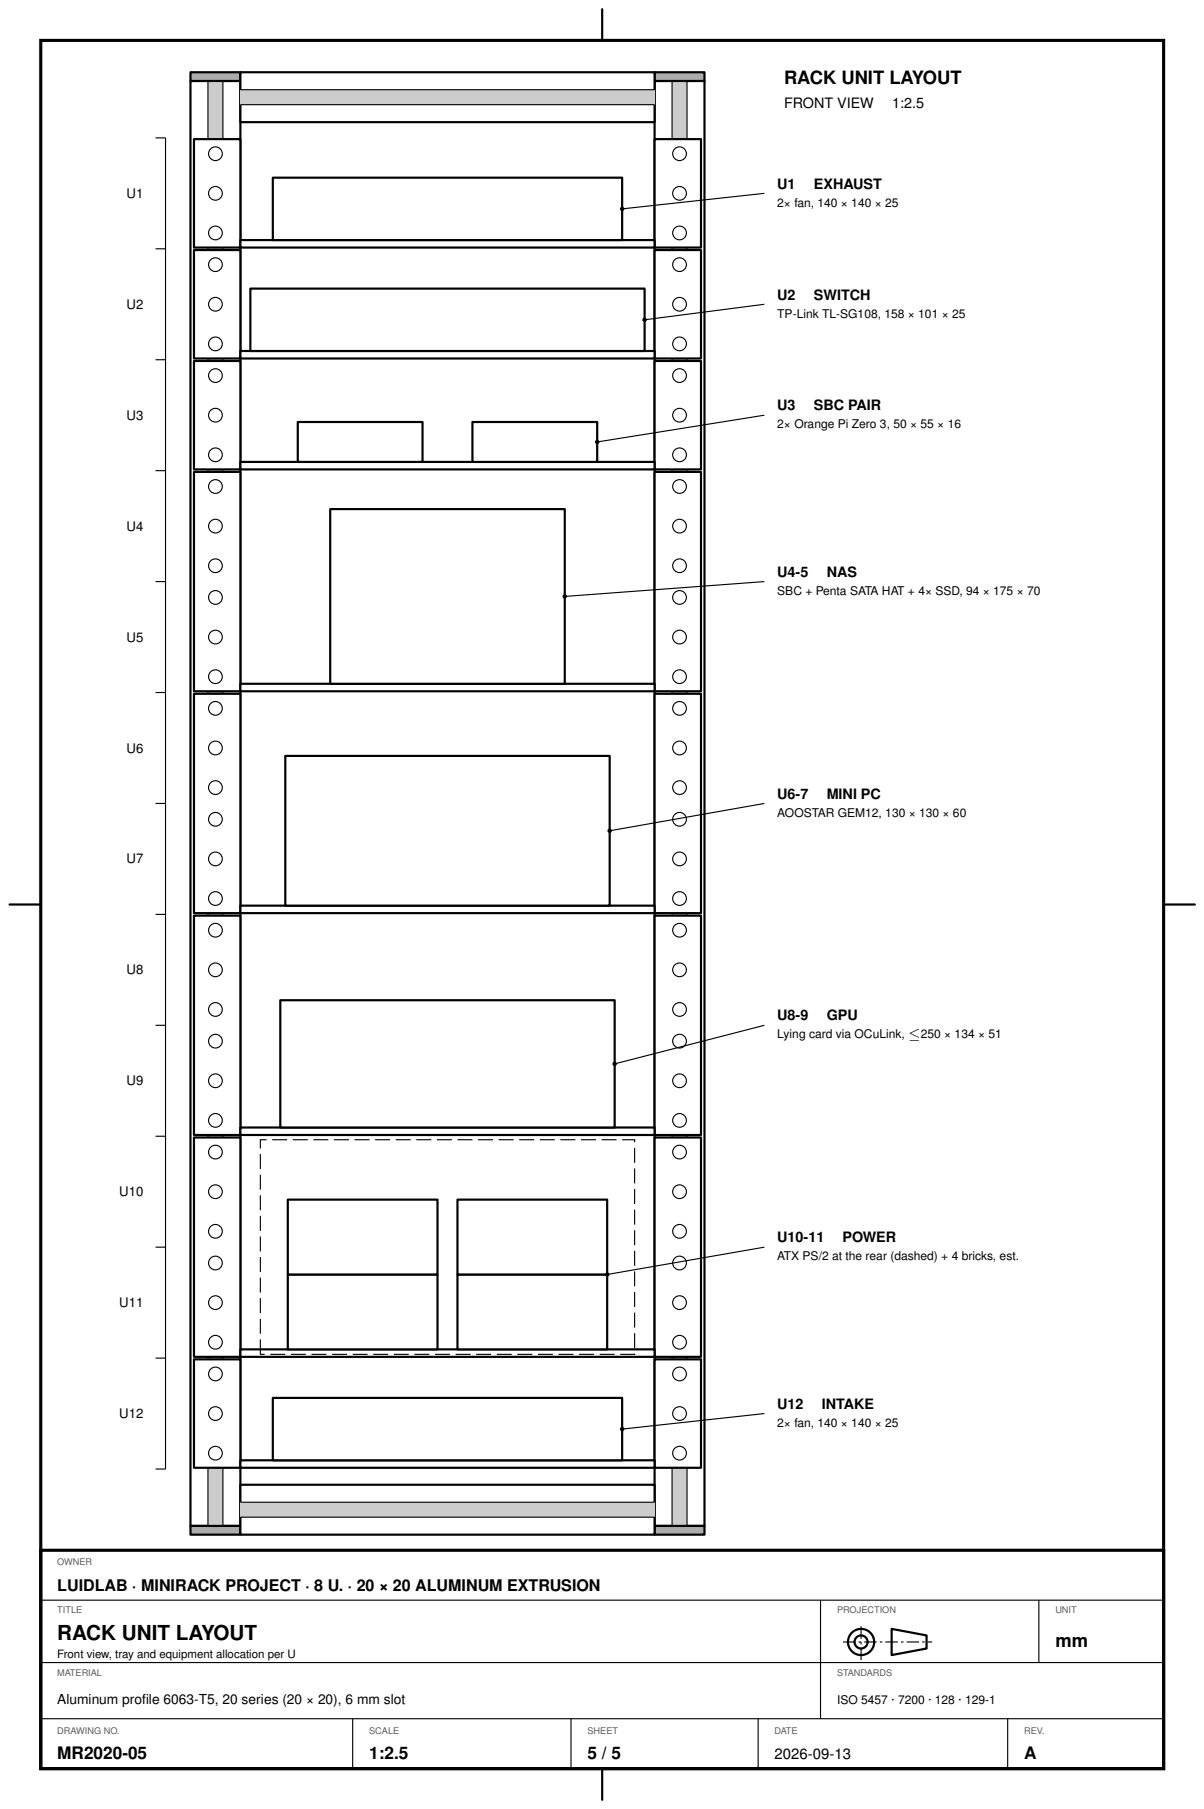
[picture p8: page 5]

SBC + Penta SATA HAT + 4× SSD, 94 × 175 × 70

Lying card via OCuLink, ≤250 × 134 × 51

ATX PS/2 at the rear (dashed) + 4 bricks, est.

OWNER
LUIDLAB · MINIRACK PROJECT · 8 U. · 20 × 20 ALUMINUM EXTRUSION

Front view, tray and equipment allocation per U
