Luidooo/luidlab/(commit log)

2026-10-14 feat(rack): add L corner brackets and hardware list
    Draw the 32 L brackets on sheets 01, 02 and 04: two at each back vertex,
    two at each front intermediate joint and four at each back intermediate
    joint, none at the front vertices. Sheet 02 now lists the purchased
    hardware (corner connectors, L brackets, hammer nuts, button head
    screws) with what is already in stock, mirrored in the rack README.
2026-10-14 docs(rack): specify M5 thread for hammer nuts and screws
2026-10-14 docs(rack): add M4 headless screws for the 3-way corner connectors
2026-10-14 docs(rack): set corner connector screws to M4 x 3, eight per connector
2026-10-14 fix(rack): corner connector plate is 3.5 mm, frame height 586
    The 3-way corner connector plate measures 3.5 mm, not 5 mm. Uprights stay
    cut to 579, so the frame drops to 586 and the U zone, centred on the
    uprights, moves to 26.3..559.7 from the base. Intermediate rails are now
    at 248.55 and 426.35 from the base; their marks on the uprights
    (235.05 and 412.85 from the bottom end) are unchanged.
2026-10-29 docs(rack): L brackets at every vertex, flat ones in base and top frames
    Brackets now go on the front vertices too, plus one lying flat at each
    inner corner of the base and top frames: 48 in all, three per vertex.
    Hardware list updated to 96 hammer nuts and 96 M5 x 8 screws.
2026-10-29 feat(rack): 3D frame model, 1U nut block drawing and fit test piece
    - modelos3d/estrutura.sc: SolidCraft model of the frame (2020 profiles,
    corner connectors, 48 ribbed L brackets)
    - desenhos/bloco-1u: proposal sheet for the printed 1U block that holds
    the three M5 drop-in nuts of a rack unit inside the front slot
    - modelos3d/teste-bloco-1u: three 15 mm test blocks (width -0.4, 0, +0.4)
    to find the slot fit before printing the 24 blocks
    - iso.sty: title block material and date can be overridden per sheet
    [teste-bloco-1u.stl]
2026-11-05 refactor(rack): drop the intermediate rails, frame closed at base and top only
    The frame is rigid enough with the base and top rectangles. Removes the
    two back width rails and four side depth rails at the U3/U4 and U7/U8
    boundaries, with their L brackets: 4 + 4 rails (4220 mm of profile),
    24 brackets, 48 hammer nuts and 48 M5 x 8 screws. Drawings, README and
    the 3D frame model updated.
